selmah9/System-for-distributed-water-level-measurement/PHP/img/slika1.jpg

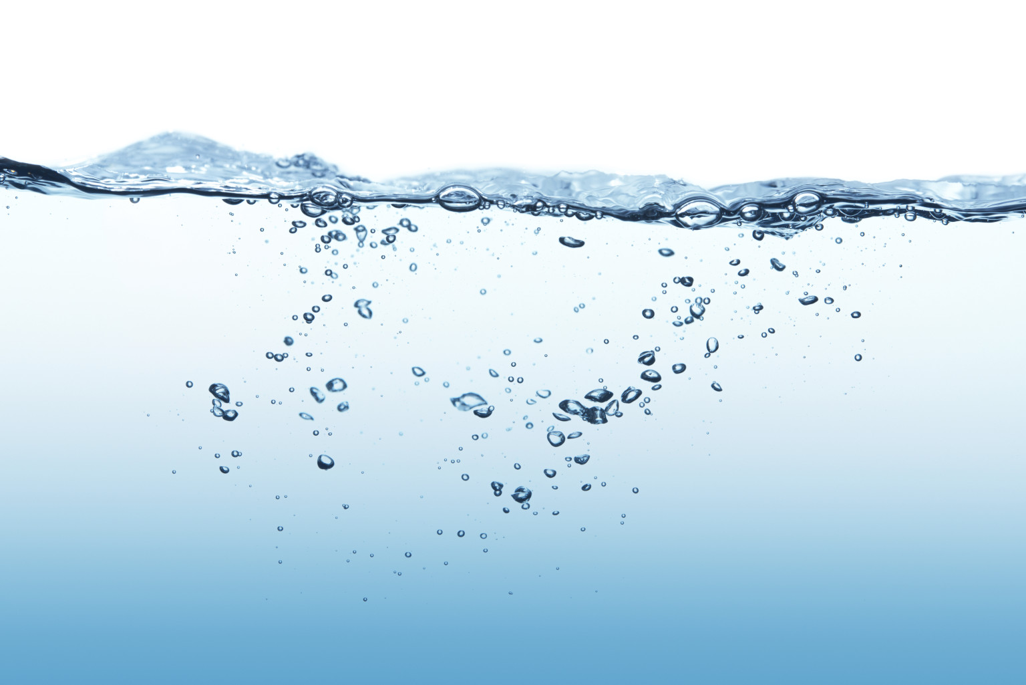
PHP/img/slika1.jpg
