selmah9/System-for-distributed-water-level-measurement/README.md

# System-for-distributed-water-level-measurement
Sistem za distribuirano mjerenje nivoa vode
